mregueira/TemporizadorAC/DOC/documentation/Documentacion/V623/preamble.tex

\usepackage[utf8]{inputenc}
% caracteres utf8 (tildes, enie) sin tener que usar comandos

\usepackage[spanish, es-tabla, es-nodecimaldot]{babel} 
% texto automatico en espaniol
% "tabla" en vez de "cuadro"
% no reemplaza puntos decimales por comas

%% NO AGREGAR PAQUETES ANTES DE ESTO, ES IMPORTANTE QUE BABEL ESTE PRIMERO

%%%%%%%%%%%%%%%%%%%%%%%%%%%%%%%%%
%% PAQUETES EXTRA %%%%%%%%%%%%%%%
%%%%%%%%%%%%%%%%%%%%%%%%%%%%%%%%%

\usepackage{subfiles}

\usepackage{amsmath} % PAQUETES DE MATEMATICA
\usepackage{amsfonts}
\usepackage{amssymb}

\usepackage{steinmetz} % comando \phase{}
\usepackage{units} % permite usar nicefrac
\usepackage{graphicx} % importar imagenes
\usepackage{float} % posicion H para floats
\usepackage[colorinlistoftodos]{todonotes}

\usepackage[a4paper]{geometry} 
% margenes correctos en subarchivos

\setlength{\parindent}{10pt}			%cuanta sangria al principio de un parrafo
\usepackage{indentfirst}				%pone sangria al primer parrafo de una seccion

\usepackage{fancyhdr}
\usepackage{lscape}
\usepackage{units}

\geometry{top=2.5cm, bottom=2.0cm, left=2.25cm, right=2.25cm}

\lhead{Elec Air}
\chead{Placa Tiempo Universal}
\rhead{Datasheet}
\renewcommand{\headrulewidth}{1pt}
\renewcommand{\footrulewidth}{1pt}

\pagestyle{fancy}

%%%%%%%%%%%%%%%%%%%%%%%%%%%%%%%%%%%%%%%%%%%%%%%%%%%%%%%%%%%
%% NO AGREGAR PAQUETES DESPUES DE ESTO, ES IMPORTANTE QUE HYPERREF ESTE ULTIMO
\usepackage[hidelinks]{hyperref} % hipervinculos sin cajitas rojas
