mregueira/TemporizadorAC/DOC/documentation/Documentacion/V501/DocumentoPlaca22-05-20.pdf

Elec Air | Placa Tiempo Universal | Datasheet

### Placa de Tiempo Universal - Elec Air

Placa Esquem´atica


Descripci´on

Placa universal de tiempos adaptable a tres circuitos de encendido, tanto por chispa, por incandescente, y por v´alvula electr´onica. Se adjuntan los planos de conexionado correspondientes en las secciones siguientes.

Equipos compatibles

Calefactores GOODMAN

Calefactores CARRIER

Calefactores GOODMAN-CARRIER

Calefactores GOODMAN-SURREY

Calefactores (Ex) CONFORMAKER

Circuito el´ectrico - Versi´on por chispa

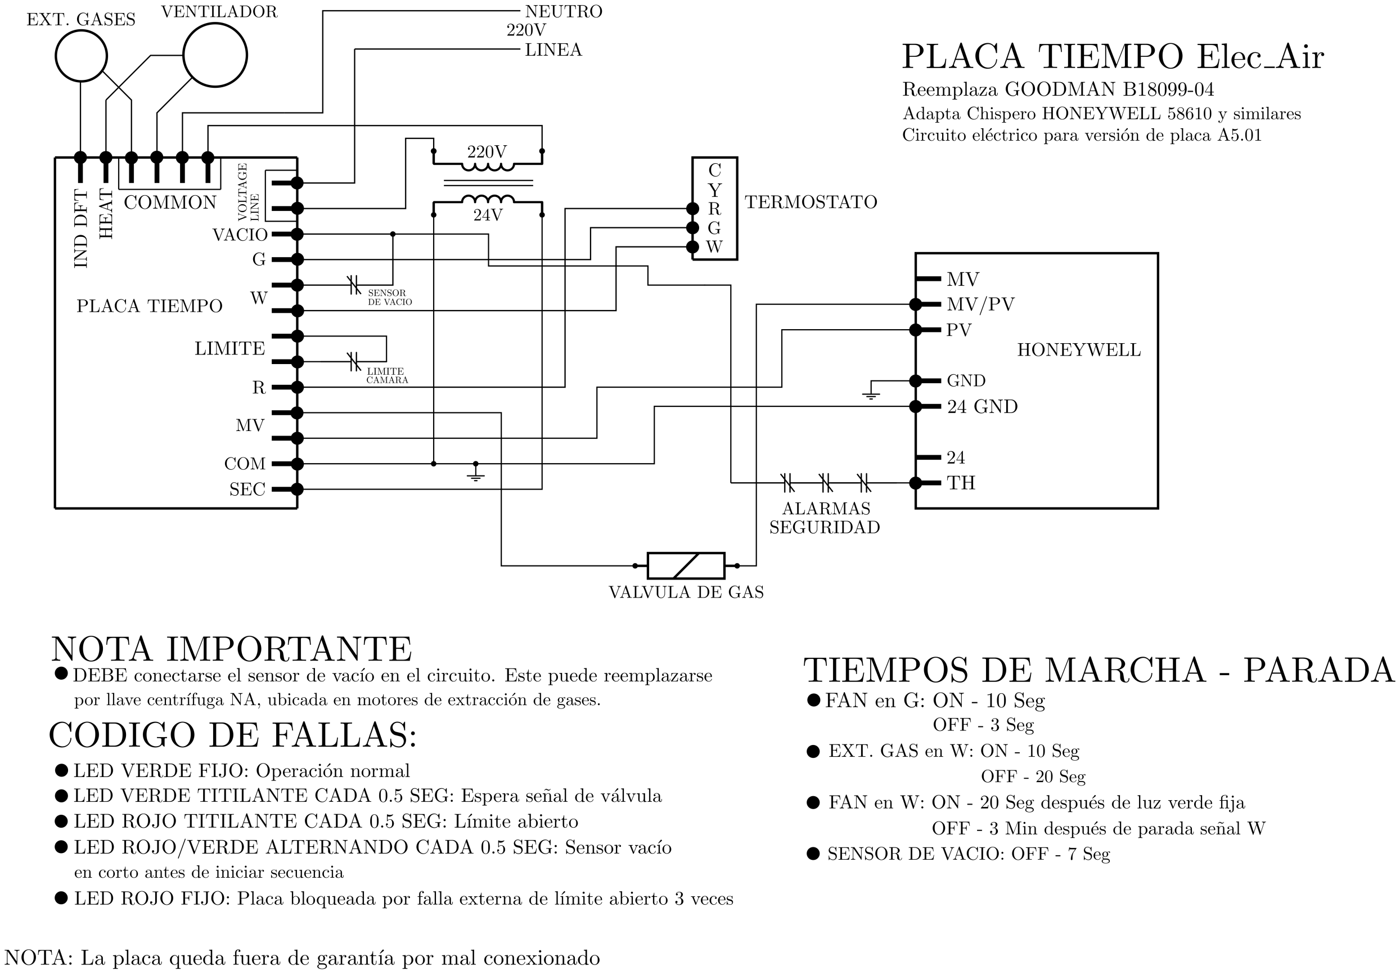
[picture p44: figure]

Notas

Los momentos de funcionamiento de la placa de tiempos est´an superditados a las funciones de encendido generadas por la placa de chispa. Estas est´an dadas por el fabricante de esa ´ marca.
Si la placa de encendido no funciona, la placa de tiempo no realiza su ciclo de programa por seguridad.

Circuito el´ectrico - Versi´on por superficie caliente

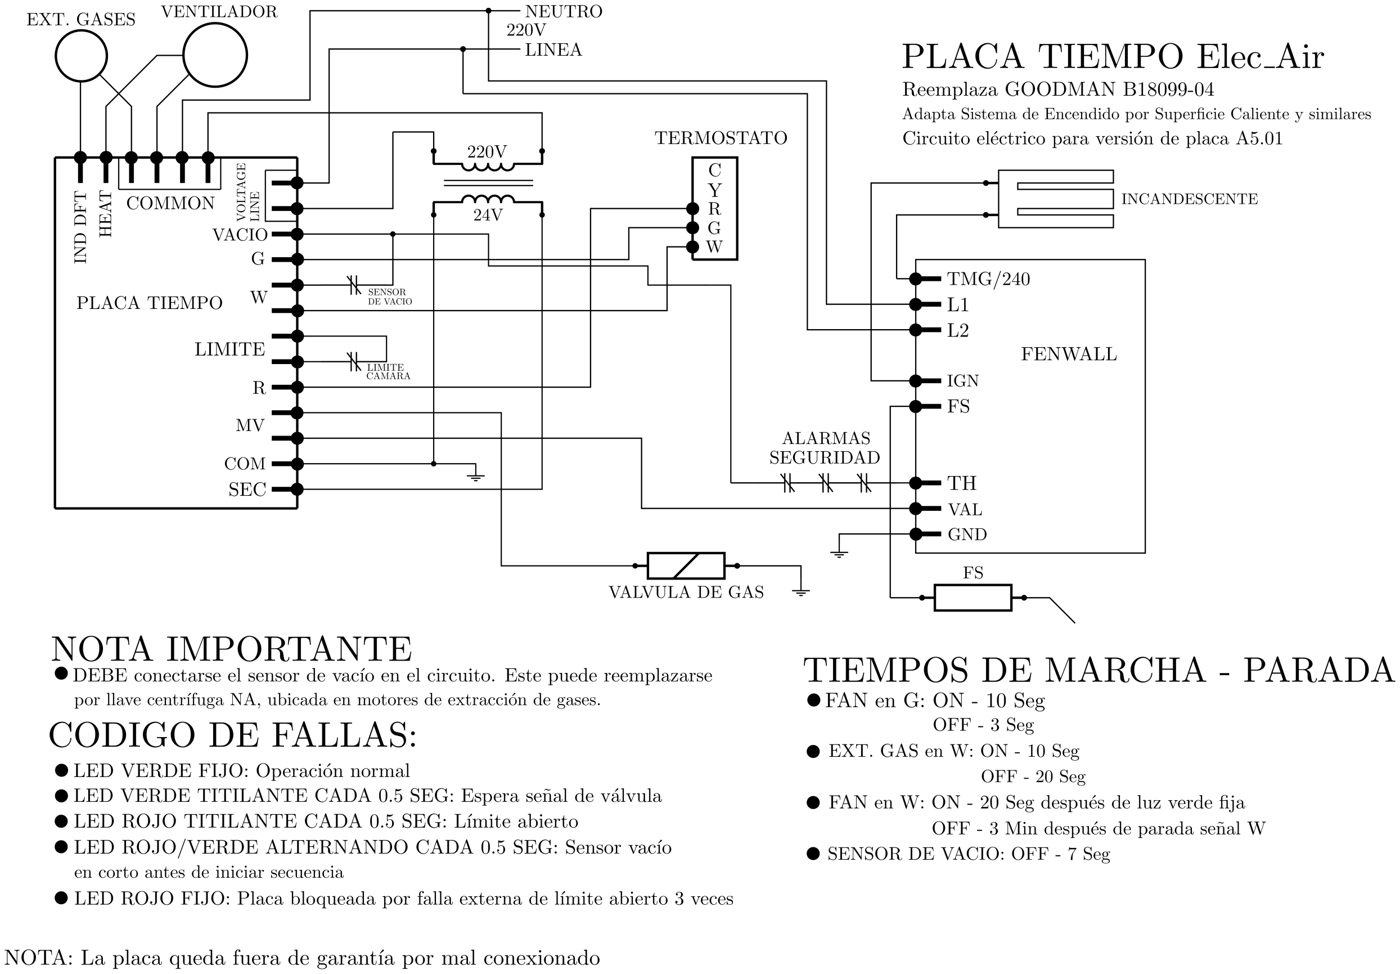
[picture p45: figure]

Notas

Al igual que el encendido por chispa, los momentos de funcionamiento de la placa de tiempos est´an superditados a las funciones de encendido generadas por la placa de incandescente. Estas est´an dadas por el fabricante de esa marca. ´
Si esta ´ultima no funciona, la placa de tiempos no realiza su ciclo de programa, por seguridad.

Circuito el´ectrico - Versi´on por v´alvula

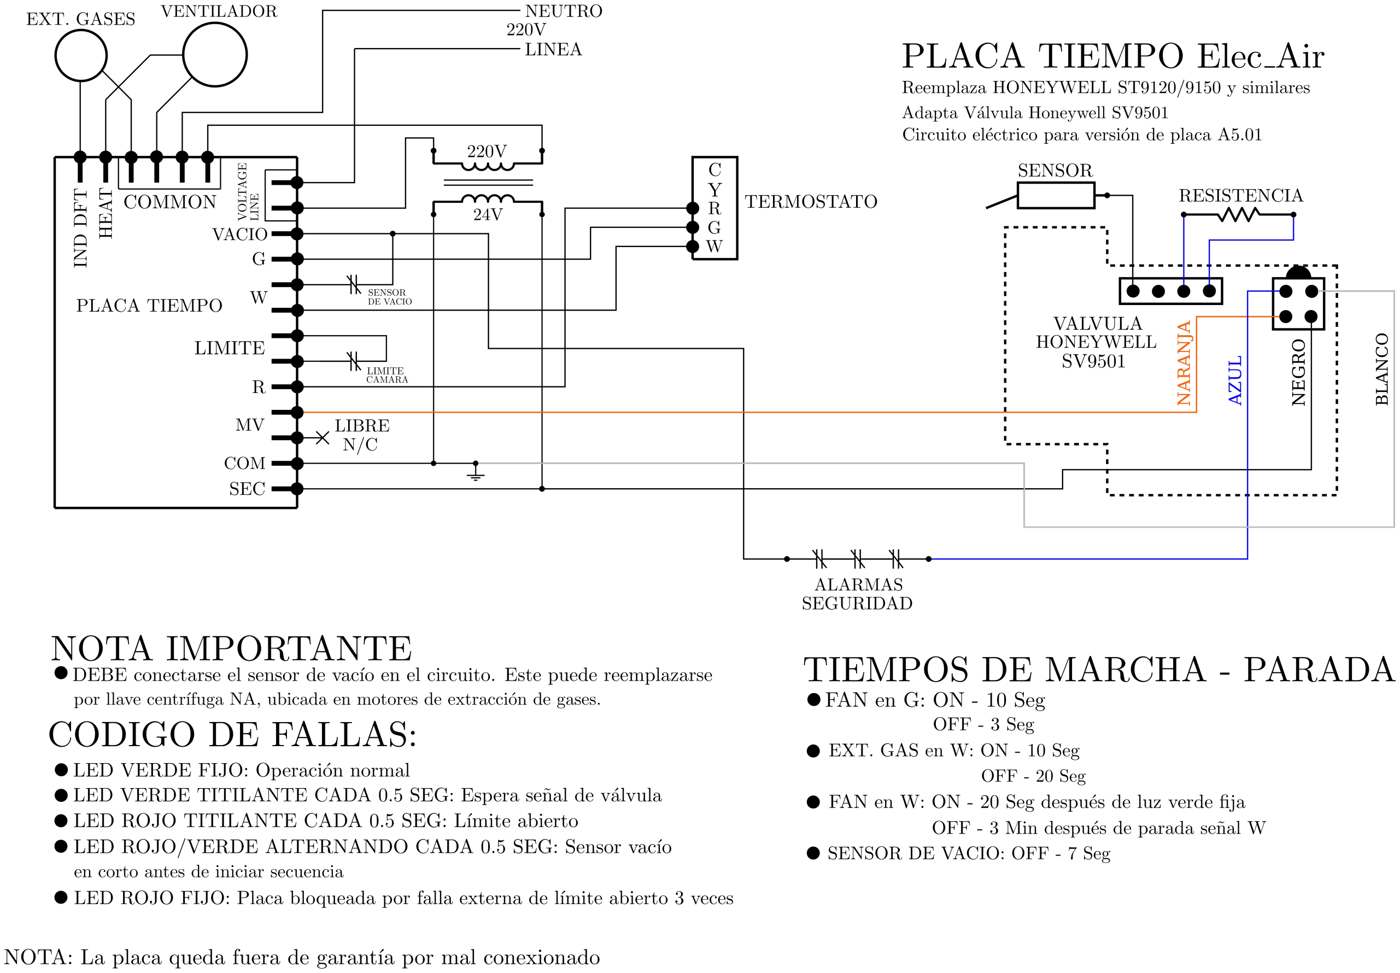
[picture p46: figure]

Notas

Al igual que el encendido por chispa, los momentos de funcionamiento de la placa de tiempos est´an superditados a las funciones de encendido generadas por la placa de incandescente. Estas est´an dadas por el fabricante de esa marca. ´
Si esta ´ultima no funciona, la placa de tiempos no realiza su ciclo de programa, por seguridad.
