mregueira/TemporizadorAC/DOC/profits/Temporizador_v811 - Gastos - 11-07-2023.xlsx

Item | Costo | Qty | Marcelo
JLC x20 | 215.63 | 1 | 215.63
Aduana | 174.49 | 1 | 174.49
LED | 0.49 | 20 | 9.8
Pala | 0.13 | 400 | 52
Rele 2 INV | 5.04 | 20 | 100.8
Rele Martillo | 5.99 | 20 | 119.8
CAP 0.33uF | 0.14 | 20 | 2.8
CAP 10uF/50V | 0.078 | 140 | 10.92
CAP 100uF/63V | 0.31 | 20 | 6.2
LM7824 | 1.11 | 20 | 22.2
LM317 | 1.57 | 20 | 31.4
0R 1206 | 0.03 | 20 | 0.6
Separador T-R | 0.34 | 40 | 13.6
Separador T-T | 0.34 | 20 | 6.8 | Costo Fabricacion/u | Precio Venta | Ganancia %
 |  |  | 767.04 | 38.352 | 95 | 59.62947368
Pago 1 |  |  | 0
Pago 2 |  |  | 0
Pago 3 |  |  | 0
Pago 4 |  |  | 0
Pago 5 |  |  | 0
Pago 6 |  |  | 0
Pago 7 |  |  | 0
Pago 8 |  |  | 0
Pago 9 |  |  | 0
Pago 10 |  |  | 0
 |  |  | 0
