mregueira/TemporizadorAC/DOC/profits/Temporizador_v701_SMD-Codes.xlsx

Comment | JLC Part | Description | Designator | Footprint | Quantity
10uF/50V | C440198 | CAP SMD | C1_FAN, C1_HEAT, C1_LIMIT, C1_VACUUM, C1_VALVE | 0805 | 5
0.1uF | C28233 | CAP SMD | C1_POW, C1_UC_INT, C2_POW, C2_UC_INT, C3_UC_INT, C4_POW, C4_UC_INT, C5_UC_INT, C6_UC_INT, C7_UC_INT, C8_UC_INT, CD1_UC_INT | 0805 | 12
0.33uF | C1740 | CAP SMD | C3_POW | 0805 | 1
100uFx63V | C178628 | CAP SMD | C5_POW | EEETG1J101UP | 1
10uF/50V | C440198 | CAP SMD | CADJ_POW | 0805 | 1
1N4148 | C81598 | Diode Schottky | D1_ACT_INT, D2_ACT_INT | SOD-123 | 2
1N4007 | C2892673 | Diode Rectifier 1A 1kV | D1_FAN, D1_HEAT, D1_LIMIT, D1_POW, D1_VACUUM, D1_VALVE, D2_POW, D3_POW, D4_POW | SMA(DO-214AC) | 9
MMSZ18T1G | C40707 | Diode Zener 18V | D2_FAN, D2_HEAT, D2_LIMIT, D2_VACUUM, D2_VALVE | SOD-123 | 5
DB107S | C5377 | BRIDGE 1000V | DB1_POW | DB-S | 1
LED |  | LED 5MM | DL1_ACT_INT | LED-5MM - BI | 1
1N5349 |  | Diode Zener | DZ1_POW | DO40 | 1
R |  | TAB | J1_IN_TAB | TAB250 | 20
FAN |  | RELE | M1_ACT_INT | HJQ-15F-FORM-C | 1
EXT |  | RELE | M2_ACT_INT | HRJ-3FF-Form-C | 1
8K2/1% | C17828 | RES SMD | R1_ACT_INT, R2_ACT_INT | 0805 | 2
3K3/1% | C26010 | RES SMD | R1_FAN, R1_HEAT, R1_LIMIT, R1_VACUUM, R1_VALVE | 0805 | 5
240/1% | C17572 | RES SMD | R1_POW | 0805 | 1
4K7/1% | C17673 | RES SMD | R1_UC_INT | 0805 | 1
5K6/1% | C4382 | RES SMD | R2_FAN, R2_HEAT, R2_LIMIT, R2_VACUUM, R2_VALVE | 0805 | 5
390/1% | C17655 | RES SMD | R2_POW | 0805 | 1
390/3W |  | POWER RES THT | RP1_POW, RP2_POW | RES1000 - NOSILK | 2
ULN2003 |  | DARLINGTON ARRAY | U1_ACT_INT | DIP16 | 1
TLP521-1XSM | C83157 | OPTOCOUPLER | U1_FAN, U1_HEAT, U1_LIMIT, U1_VACUUM, U1_VALVE | SMD-4P | 5
L7824ACV-DG |  | LINEAR REG | U1_POW | TO-220 - DG | 1
STM32F031F6P7 | C117472 | IC MCU 32BIT 32KB FLASH 20TSSOP | U1_UC_INT | 20-TSSOP | 1
LM317KCS |  | LINEAR REG | U2_POW | TO-220 - KCS0003B | 1
4.7uF/25V | C1779 | CAP SMD |  | 0805
47K/1% | C17713 | RES SMD |  | 0805
SI2301CDS-T1-GE3 | C10487
MMBT3904 | C20526
10K/1% | C17414 | RES SMD |  | 0805
1K/1% | C17513 | RES SMD |  | 0805
