mregueira/TemporizadorAC/DOC/profits/Temporizador_V801_THT-Codes.xlsx

Comment | JLCPart | Designator | Footprint | Quantity
10uF/50V | C2940713 | CADJ_POW | CAP-100RP | 1
1N5349 | C232446 | DZ1_POW | DO40 | 1
100uFx63V | C165651 | C5_POW | CAP-200RP | 1
4.7uF/50V | C29823 | CB1_UC_INT | 1206-CAP-TDK | 1
0.33uF | C2761750 |  | CAP-200 | 1
0.1uF | C24497 | C1_ACT_INT, C1_POW, C1_UC_INT, C2_POW, C4_POW, CD1_UC_INT, CD2_UC_INT | 1206-CAP-TDK | 7
1N4007 | C3033995 | D1_FAN, D1_HEAT, D1_LIMIT, D1_POW, D1_VACUUM, D1_VALVE, D2_POW, D3_POW, D4_POW | DO-41 | 9
1N4148 | C258182 | D1_ACT_INT, D2_ACT_INT | DO-35 | 2
3K3/1% | C119335 | R1_FAN, R1_HEAT, R1_LIMIT, R1_VACUUM, R1_VALVE | RES400 | 5
4K7/1% | C17936 | R1_UC_INT | 1206-RES-PANASONIC | 1
5K6/1% | C173035 | R2_FAN, R2_HEAT, R2_LIMIT, R2_VACUUM, R2_VALVE | RES400 | 5
8K2/1% | C129913 | R1_ACT_INT, R2_ACT_INT | RES400 | 2
10uF/50V | C2940713 | C1_FAN, C1_HEAT, C1_LIMIT, C1_VACUUM, C1_VALVE, C2_ACT_INT | CAP-100RP | 6
240/1% | C119310 | R1_POW | RES400 | 1
390/1% | C119315 | R2_POW | RES400 | 1
390/3W | C348872 | RP1_POW, RP2_POW | RES1000 - NOSILK | 2
DB107S | C5377 | DB1_POW | DBS | 1
1N4746A-G | C391338 | D2_FAN, D2_HEAT, D2_LIMIT, D2_VACUUM, D2_VALVE | DO-41G | 5
STM32F031F6P7 | C117472 | U1_UC_INT | ST-TSSOP-20 - STM32F031F6P7 | 1
TLP521-1GB | C69256 | U1_FAN, U1_HEAT, U1_LIMIT, U1_VACUUM, U1_VALVE | DIP4 | 5
ULN2003 | C93000 | U1_ACT_INT | DIP16 | 1
