mregueira/TemporizadorAC/DOC/profits/Temporizador_v701 - Gastos - 10-07-2022.xlsx

Comment | Description | Total Final | $/u | USD/u | Total | Total (USD) | Daniel | Marcelo |  | Dolar hoy 20-09-2022 | Dolar 10-07-2022
10uF/25V | Cap Electrolitico 2.5mm Diametro | 140 | 6 |  | 840 | 6.32 | 6.32 |  |  | 150 | 133
0.1uF | Cap Multicapa | 360 | 5.2 |  | 1872 | 14.08 | 14.08
0.33uF | Cap Multicapa | 30 | 7.95 |  | 238.5 | 1.79 | 1.79
100uFx63V | Cap Electrolitico 5mm Diametro | 30 | 17 |  | 510 | 3.83 | 3.83
1N4148 | Diode Schottky | 60 | 2.25 |  | 135 | 1.02 | 1.02
1N4007 | Diode Rectifier | 270 | 3.35 |  | 904.5 | 6.80 | 6.80
1N4746 | Diode Zener | 150 | 12.35 |  | 1852.5 | 13.93 | 13.93
W10M | Puente de Diodos | 30 | 31.9 |  | 957 | 7.20 | 7.20
LED | Led 5mm Bicolor 2 Patas | 30 | 27.9 |  | 837 | 6.29 | 6.29
1N5349 | Diode Zener | 30 | 66.9 |  | 2007 | 15.09 | 15.09
FAN | Rele Martillo 24V 10A | 30 | 330 |  | 9900 | 74.44 | 74.44
EXT | Rele 24V 10A | 15 | 125 |  | 1875 | 14.10 | 14.10
SEP Traba/Rosca | Separador Traba/Rosca 9.5mm | 60 | 18.9 |  | 1134 | 8.53 | 8.53
SEP Traba/Traba | Separador Traba/Traba 6.4mm | 30 | 16.5 |  | 495 | 3.72 | 3.72
8K2/1% | Res MetalFilm 1/8W | 60 | 3.2 |  | 192 | 1.44 | 1.44
3K3/1% | Res MetalFilm 1/8W | 150 | 3.2 |  | 480 | 3.61 | 3.61
240/1% | Res MetalFilm 1/8W | 30 | 3.2 |  | 96 | 0.72 | 0.72
4K7/1% | Res MetalFilm 1/8W | 30 | 3.2 |  | 96 | 0.72 | 0.72
5K6/1% | Res MetalFilm 1/8W | 150 | 3.2 |  | 480 | 3.61 | 3.61
390/1% | Res MetalFilm 1/8W | 30 | 3.2 |  | 96 | 0.72 | 0.72
390/3W | Res MetalFilm 3W | 60 | 18.9 |  | 1134 | 8.53 | 8.53
ULN2003 | IC Driver 16-DIP | 30 | 95 |  | 2850 | 21.43 | 21.43
TLP521-1 | IC Optocoupler 4-DIP | 150 | 40 |  | 6000 | 45.11 | 45.11
L7824ACV-DG | IC Reg Lineal 24V TO-220 | 30 | 73.5 |  | 2205 | 16.58 | 16.58
MC9S08SH8 | IC MCU 8BIT 8K FLASH 20-DIP | 30 |  | 9.39 | 0 | 281.70 |  | 281.7
LM317KCS | IC Reg Lineal ADJ TO-220 | 30 | 103 |  | 3090 | 23.23 | 23.23
PCB | JLC | 30 |  |  | 0 | 61.63 |  | 61.63
PCB Impuestos | Aduana | 1 | 4903 |  | 4903 | 36.86 |  | 36.86
Horas Hombre | 5 USD/Hora (1 mes en total) | 1 |  |  |  | 750.00 |  | 230.00
 |  |  | 5923.8 |  | 45179.5 | 1433.03 | 302.83 | 610.19
 |  |  |  |  | C/U | 47.77 | 65484.13805 | 131948.4936 | 202051.5064 | 136567.3683 | 68283.68416
