mregueira/TemporizadorAC/DOC/profits/Temporizador_v801 - Gastos - 15-04-2023.xlsx

Item | Costo | Qty | Marcelo
JLC x10 | 139.93 | 1 | 139.93
Aduana | 123.86 | 1 | 123.86
5 USDxHora | 0 | 20 | 0
LED | 0.27 | 10 | 2.7
Pala | 0.2 | 200 | 40
Rele | 1.85 | 10 | 18.5
Rele Martillo | 5.18 | 10 | 51.8
LM7824 | 1.13 | 10 | 11.3
LM317 | 1.62 | 10 | 16.2
0R 1206 | 0.02 | 10 | 0.2
Separador T-R | 0.35 | 20 | 7
Separador T-T | 0.3 | 10 | 3 | Costo Fabricacion/u | Precio Venta
 |  |  | 414.49 | 41.449 | 70
Pago 1 | -400 | 1 | -400
Pago 2 | -120 | 1 | -120
Pago 3 | -40 | 1 | -40
Pago 4 |  |  | 0
Pago 5 |  |  | 0
Pago 6 |  |  | 0
Pago 7 |  |  | 0
Pago 8 |  |  | 0
Pago 9 |  |  | 0
Pago 10 |  |  | 0 | Unidades equivalentes
 |  |  | -560 | 8
