mregueira/TemporizadorAC/DOC/profits/Temporizador_v811 - Gastos - 06-07-2023.xlsx

Item | Costo | Qty | Marcelo
JLC x15 | 189.72 | 1 | 189.72
Aduana | 162.95 | 1 | 162.95
1N5349 | 1.2 | 15 | 18
LED | 0.5 | 15 | 7.5
Pala | 0.13 | 300 | 39
Rele | 4.95 | 15 | 74.25
Rele Martillo | 6.13 | 15 | 91.95
LM7824 | 1.13 | 15 | 16.95
LM317 | 1.6 | 15 | 24
0R 1206 | 0.03 | 15 | 0.45
Separador T-R | 0.35 | 30 | 10.5
Separador T-T | 0.34 | 15 | 5.1 | Costo Fabricacion/u | Precio Venta
 |  |  | 640.37 | 42.69133333 | 70
Pago 1 |  |  | 0
Pago 2 |  |  | 0
Pago 3 |  |  | 0
Pago 4 |  |  | 0
Pago 5 |  |  | 0
Pago 6 |  |  | 0
Pago 7 |  |  | 0
Pago 8 |  |  | 0
Pago 9 |  |  | 0
Pago 10 |  |  | 0
 |  |  | 0
