mregueira/TemporizadorAC/(threads)

Thread 6 (2023-05-24):

[HW] Relay thermal relief

mregueira, 2023-05-24:
Fix thermal relief track width on relay pads.

Closed 2023-07-07.
