mregueira/TemporizadorAC/(list of files, drawings)

Other design files:
PCB/TEMP008-1P-2O.PcbDoc
SCH/Actuators_Interface.SchDoc
SCH/Debug_Port.SchDoc
SCH/Input_TAB.SchDoc
SCH/InputISO_Block.SchDoc
SCH/Output_TAB.SchDoc
SCH/Power_Block.SchDoc
SCH/Power_Switch.SchDoc
SCH/Sensors_Interface.SchDoc
SCH/Temporizador_V8_top.SchDoc
SCH/uC_Interface.SchDoc
Temporizador_V7.PrjPcb
Temporizador_V8.PrjPcb
