mregueira/TemporizadorAC/(commit log)

2023-04-06 updated project structure
    [Actuators_Interface.SchDoc, InputISO_Block.SchDoc, Input_TAB.SchDoc, Output_TAB.SchDoc, Power_Block.SchDoc, Sensors_Interface.SchDoc, TEMP007-1P-2O.PcbDoc, Temporizador_V7 - Gastos.xlsx]
2023-04-06 testing git ignore
    [InputISO_Block.SchDoc]
2023-04-09 changing components
    [Actuators_Interface.SchDoc, TEMP007-1P-2O.PcbDoc, Temporizador_V7.PrjPcb, Temporizador_V7.xlsx, Temporizador_V7_SMD.xlsx]
2023-04-09 fixed git ignore
    [Temporizador_V7.xlsx]
2023-04-09 changing more components
    [TEMP007-1P-2O.PcbDoc, Temporizador_V7.PrjPcb, Temporizador_V7_SMD.xlsx, uC_Interface.SchDoc]
2023-04-09 adding debug port
    [Debug_Port.SchDoc, TEMP007-1P-2O.PcbDoc, Temporizador_V7.PrjPcb, Temporizador_V7_top.SchDoc, uC_Interface.SchDoc]
2023-04-09 components added to pcb
    [Debug_Port.SchDoc, InputISO_Block.SchDoc, Power_Block.SchDoc, TEMP007-1P-2O.PcbDoc, Temporizador_V7.PrjPcb, Temporizador_V7_SMD.xlsx, uC_Interface.SchDoc]
2023-04-09 pushing before rename
    [TEMP007-1P-2O.PcbDoc, Temporizador_V7_top.SchDoc, Temporizador_V8.PrjPcb, Temporizador_V8_top.SchDoc]
2023-04-09 updated diodes silks
    [Actuators_Interface.SchDoc, TEMP008-1P-2O.PcbDoc, Temporizador_V8.PrjPcb]
2023-04-10 added power switch
    [Power_Switch.SchDoc, TEMP008-1P-2O.PcbDoc, Temporizador_V7_SMD.xlsx, Temporizador_V8.PrjPcb, Temporizador_V8_top.SchDoc]
2023-04-10 added 3v3 debug port for programming
    [Debug_Port.SchDoc, TEMP008-1P-2O.PcbDoc, Temporizador_V8.PrjPcb, Temporizador_V8_top.SchDoc]
2023-04-12 updated placement
    [Power_Block.SchDoc, TEMP008-1P-2O.PcbDoc, Temporizador_V8.PrjPcb, uC_Interface.SchDoc]
2023-04-14 routed pcb
    [Actuators_Interface.SchDoc, Debug_Port.SchDoc, Input_TAB.SchDoc, Output_TAB.SchDoc, Power_Block.SchDoc, TEMP008-1P-2O.PcbDoc, Temporizador_V8.PrjPcb, Temporizador_V8_top.SchDoc]
2023-04-15 changed some jlc codes
    [Power_Block.SchDoc, TEMP008-1P-2O.PcbDoc, Temporizador_V8.PrjPcb, Temporizador_V8_THT.xlsx, Temporizador_V8_top.SchDoc]
2023-04-15 changed some components to tht for assy
    [Actuators_Interface.SchDoc, InputISO_Block.SchDoc, Power_Block.SchDoc, TEMP008-1P-2O.PcbDoc, Temporizador_V8.PrjPcb, Temporizador_V8_THT.xlsx, Temporizador_V8_top.SchDoc, uC_Interface.SchDoc]
2023-04-15 routed all with tht
    [TEMP008-1P-2O.PcbDoc, Temporizador_V8.PrjPcb]
2023-04-16 released to manufacturing
    [Actuators_Interface.SchDoc, InputISO_Block.SchDoc, TEMP008-1P-2O.PcbDoc, Temporizador_V8.PrjPcb, Temporizador_V8_THT.xlsx]
2023-05-21 added stm32 soft - tbtested
2023-05-24 added payments
    [Temporizador_v8 - Gastos.xlsx]
2023-05-24 added last costs
    [Temporizador_v8 - Gastos.xlsx]
2023-06-05 fixes #6 and #5
    [Actuators_Interface.SchDoc, Debug_Port.SchDoc, InputISO_Block.SchDoc, Input_TAB.SchDoc, Output_TAB.SchDoc, Power_Block.SchDoc, TEMP008-1P-2O.PcbDoc, Temporizador_V8.PrjPcb]
2023-06-05 changed programing connector
    [Debug_Port.SchDoc, TEMP008-1P-2O.PcbDoc, Temporizador_V8.PrjPcb]
2023-06-05 updated connector debug
    [TEMP008-1P-2O.PcbDoc, Temporizador_V8.PrjPcb]
2023-06-07 adding relay double
    [Actuators_Interface.SchDoc, Input_TAB.SchDoc, TEMP008-1P-2O.PcbDoc, Temporizador_V8.PrjPcb, Temporizador_V8_top.SchDoc]
2023-06-08 updated pcb
    [Actuators_Interface.SchDoc, TEMP008-1P-2O.PcbDoc]
2023-06-09 changed capacitor 10uf code
    [Actuators_Interface.SchDoc, InputISO_Block.SchDoc, Power_Block.SchDoc, TEMP008-1P-2O.PcbDoc, Temporizador_V8.PrjPcb]
2023-06-11 reduced polygon sizes
    [TEMP008-1P-2O.PcbDoc]
2023-06-14 unfitted rp2
    [Temporizador_V8.PrjPcb]
2023-06-16 updated documentation and changed part numbers 8k2 and 10uF
    [Actuators_Interface.SchDoc, TEMP008-1P-2O.PcbDoc, Temporizador_V8.PrjPcb]
2023-07-06 adding more costs
    [Temporizador_v801 - Gastos.xlsx, Temporizador_v811 - Gastos.xlsx]
2023-07-07 updated costs - boards tested ok
    [Temporizador_v811 - Gastos - 06-07-2023.xlsx, Temporizador_v811 - Gastos.xlsx]
2023-07-08 fixed outjob for cutouts
    [TEMP008-1P-2O.PcbDoc, Temporizador_V8.PrjPcb]
2023-07-20 added RDP Lvl1 to code
    [Temporizador_V8.PrjPcb, Temporizador_v811 - Gastos - 11-07-2023.xlsx]
2023-07-23 organized profits
    [Temporizador_V7_SMD.xlsx, Temporizador_V8_THT.xlsx, Temporizador_v700 - Gastos - 10-07-2022.xlsx, Temporizador_v801 - Gastos - 15-04-2023.xlsx, Temporizador_v811 - Gastos - 06-07-2023.xlsx, Temporizador_v811 - Gastos - 11-07-2023.xlsx]
2023-07-23 renamed some files
    [Temporizador_V801_THT-Codes.xlsx, Temporizador_v701 - Gastos - 10-07-2022.xlsx, Temporizador_v701_SMD-Codes.xlsx]
